ferrox-rc/wingfc-hardware/kicad/WingFC.kicad_pcb

## KiCad design kicad/WingFC.kicad_pcb (2026-10-21)

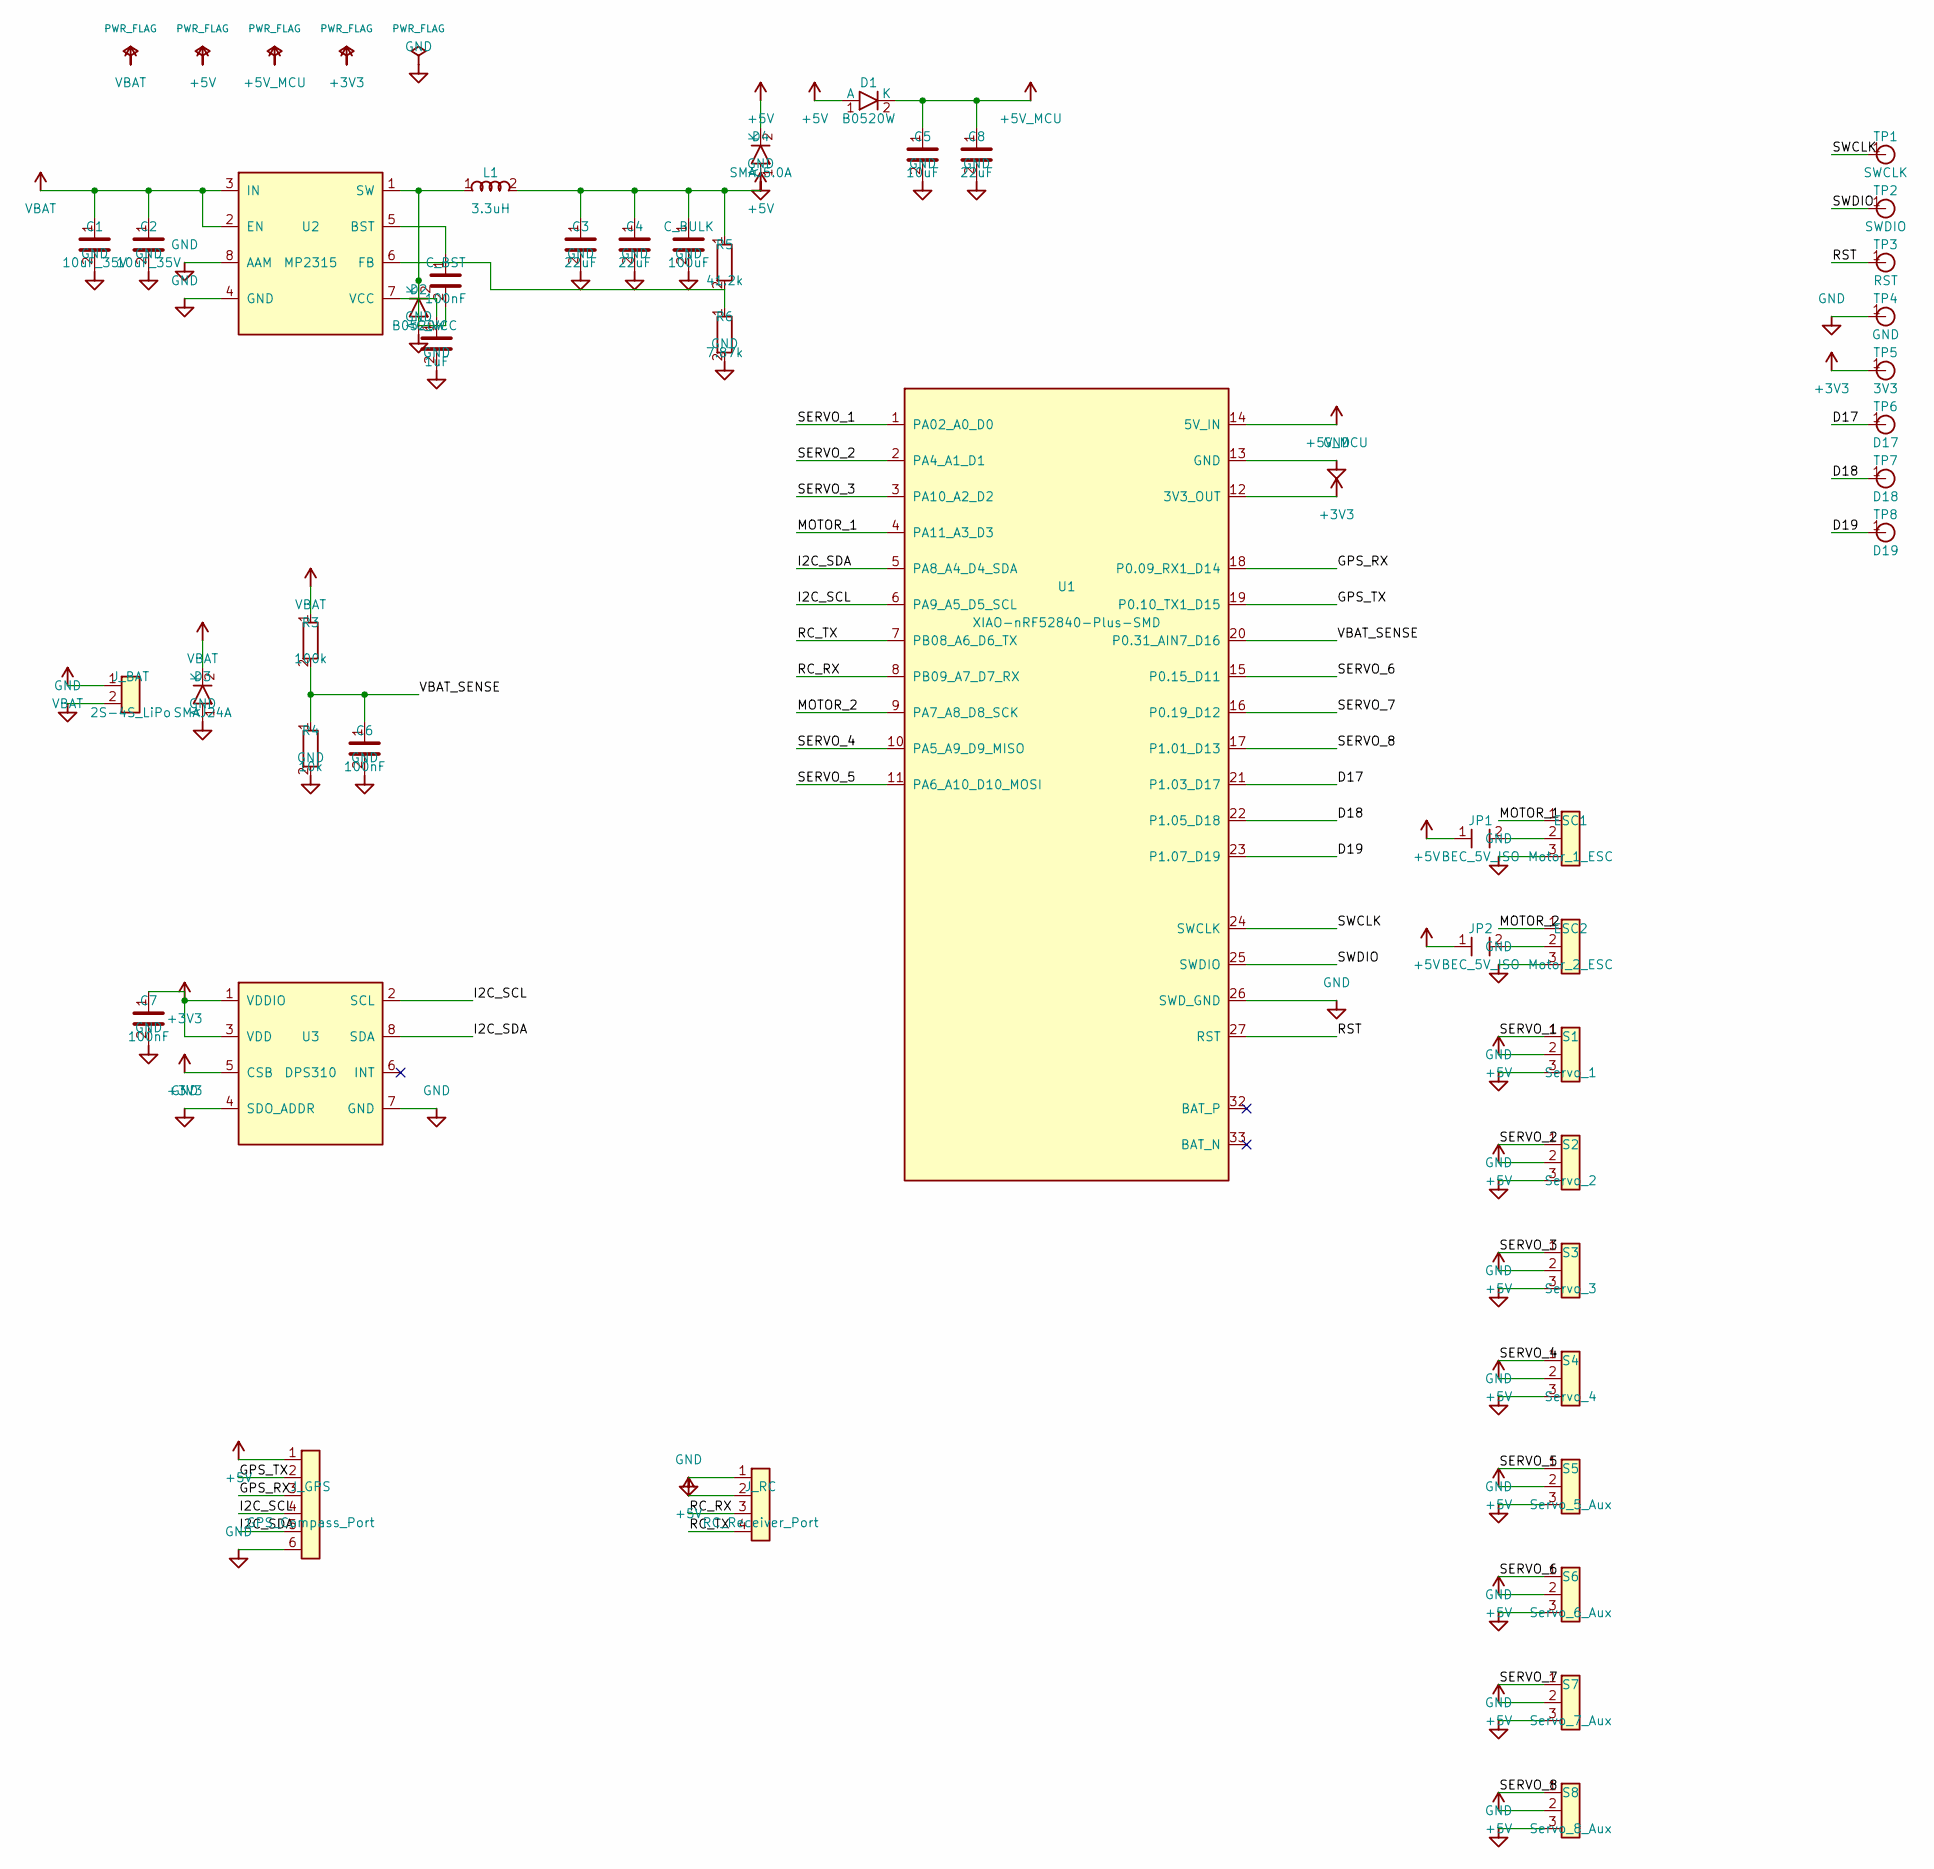
[picture p4: schematic WingFC.kicad_sch]

Parts:
C1, C2: 10uF_35V; C_0805_2012Metric
C3, C4, C8: 22uF; C_0805_2012Metric
C5: 10uF; C_0805_2012Metric
C6, C7: 100nF; C_0603_1608Metric
C_BST: 100nF; C_0603_1608Metric
C_BULK: 100uF; C_1206_3216Metric
C_VCC: 1uF; C_0603_1608Metric
D1, D2: B0520W; D_SOD-123
D3: SMAJ24A; D_SMA
D4: SMAJ5.0A; D_SMA
ESC1: Motor_1_ESC; PinHeader_1x03_P2.54mm_Vertical
ESC2: Motor_2_ESC; PinHeader_1x03_P2.54mm_Vertical
JP1, JP2: BEC_5V_ISO; SolderJumper-2_P1.3mm_Open_RoundedPad1.0x1.5mm
J_BAT: 2S-4S_LiPo; SolderWire-0.75sqmm_1x02_P4.8mm_D1.2mm_OD2.3mm
J_GPS: GPS_Compass_Port; JST_SH_SM06B-SRSS-TB_1x06-1MP_P1.00mm_Horizontal
J_RC: RC_Receiver_Port; JST_SH_SM04B-SRSS-TB_1x04-1MP_P1.00mm_Horizontal
L1: 3.3uH; L_Bourns_SRN4018
R3: 100k; R_0603_1608Metric
R4: 10k; R_0603_1608Metric
R5: 41.2k; R_0603_1608Metric
R6: 7.87k; R_0603_1608Metric
S1: Servo_1; PinHeader_1x03_P2.54mm_Vertical
S2: Servo_2; PinHeader_1x03_P2.54mm_Vertical
S3: Servo_3; PinHeader_1x03_P2.54mm_Vertical
S4: Servo_4; PinHeader_1x03_P2.54mm_Vertical
S5: Servo_5_Aux; PinHeader_1x03_P1.27mm_Vertical
S6: Servo_6_Aux; PinHeader_1x03_P1.27mm_Vertical
S7: Servo_7_Aux; PinHeader_1x03_P1.27mm_Vertical
S8: Servo_8_Aux; PinHeader_1x03_P1.27mm_Vertical
TP1: SWCLK; TestPoint_Pad_D1.5mm
TP2: SWDIO; TestPoint_Pad_D1.5mm
TP3: RST; TestPoint_Pad_D1.5mm
TP4: GND; TestPoint_Pad_D1.5mm
TP5: 3V3; TestPoint_Pad_D1.5mm
TP6: D17; TestPoint_Pad_D1.5mm
TP7: D18; TestPoint_Pad_D1.5mm
TP8: D19; TestPoint_Pad_D1.5mm
U1: XIAO-nRF52840-Plus-SMD
U2: MP2315; TSOT-23-8
U3: DPS310; Infineon_PG-VLGA-8-1_2.0x2.5mm_P0.65mm

Connections:
+3V3: C7.1, TP5.1, U1.12 (3V3_OUT), U3.1 (VDDIO), U3.3 (VDD), U3.5 (CSB)
+5V: C3.1, C4.1, C_BULK.1, D1.1 (A), D4.2 (K), JP1.1, JP2.1, J_GPS.1, J_RC.2, L1.2, R5.1, S1.2, S2.2, S3.2, S4.2, S5.2, S6.2, S7.2, S8.2
+5V_MCU: C5.1, C8.1, D1.2 (K), U1.14 (5V_IN)
/D17: TP6.1, U1.21 (P1.03_D17)
/D18: TP7.1, U1.22 (P1.05_D18)
/D19: TP8.1, U1.23 (P1.07_D19)
/GPS_RX: J_GPS.3, U1.18 (P0.09_RX1_D14)
/GPS_TX: J_GPS.2, U1.19 (P0.10_TX1_D15)
/I2C_SCL: J_GPS.4, U1.6 (PA9_A5_D5_SCL), U3.2 (SCL)
/I2C_SDA: J_GPS.5, U1.5 (PA8_A4_D4_SDA), U3.8 (SDA)
/MOTOR_1: ESC1.1, U1.4 (PA11_A3_D3)
/MOTOR_2: ESC2.1, U1.9 (PA7_A8_D8_SCK)
/RC_RX: J_RC.3, U1.8 (PB09_A7_D7_RX)
/RC_TX: J_RC.4, U1.7 (PB08_A6_D6_TX)
/RST: TP3.1, U1.27 (RST)
/SERVO_1: S1.1, U1.1 (PA02_A0_D0)
/SERVO_2: S2.1, U1.2 (PA4_A1_D1)
/SERVO_3: S3.1, U1.3 (PA10_A2_D2)
/SERVO_4: S4.1, U1.10 (PA5_A9_D9_MISO)
/SERVO_5: S5.1, U1.11 (PA6_A10_D10_MOSI)
/SERVO_6: S6.1, U1.15 (P0.15_D11)
/SERVO_7: S7.1, U1.16 (P0.19_D12)
/SERVO_8: S8.1, U1.17 (P1.01_D13)
/SWCLK: TP1.1, U1.24 (SWCLK)
/SWDIO: TP2.1, U1.25 (SWDIO)
/VBAT_SENSE: C6.1, R3.2, R4.1, U1.20 (P0.31_AIN7_D16)
GND: C1.2, C2.2, C3.2, C4.2, C5.2, C6.2, C7.2, C8.2, C_BULK.2, C_VCC.2, D2.1 (A), D3.1 (A), D4.1 (A), ESC1.3, ESC2.3, J_BAT.2, J_GPS.6, J_RC.1, R4.2, R6.2, S1.3, S2.3, S3.3, S4.3, S5.3, S6.3, S7.3, S8.3, TP4.1, U1.13 (GND), U1.26 (SWD_GND), U2.4 (GND), U2.8 (AAM), U3.4 (SDO_ADDR), U3.7 (GND)
unnamed: C_BST.2, D2.2 (K), L1.1, U2.1 (SW)
unnamed: ESC1.2, JP1.2
unnamed: ESC2.2, JP2.2
unnamed: C_BST.1, U2.5 (BST)
unnamed: R5.2, R6.1, U2.6 (FB)
unnamed: C_VCC.1, U2.7 (VCC)
VBAT: C1.1, C2.1, D3.2 (K), J_BAT.1, R3.1, U2.2 (EN), U2.3 (IN)

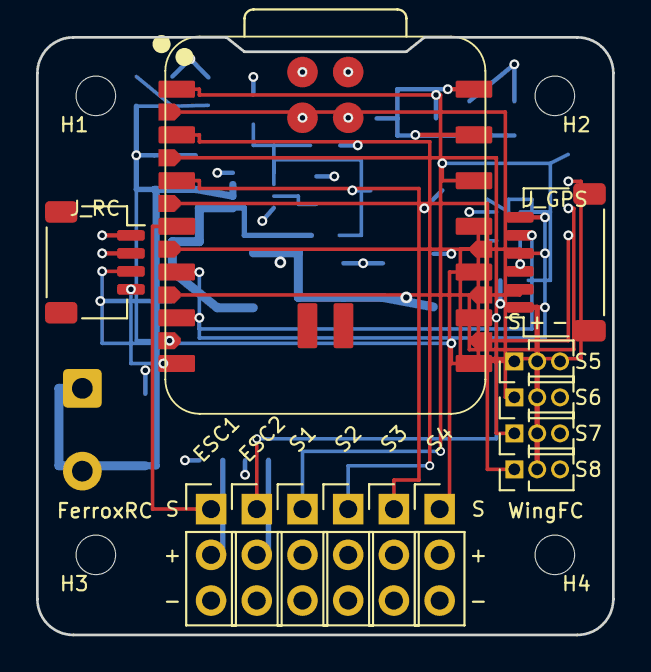
[picture p5: board WingFC.kicad_pcb from above]

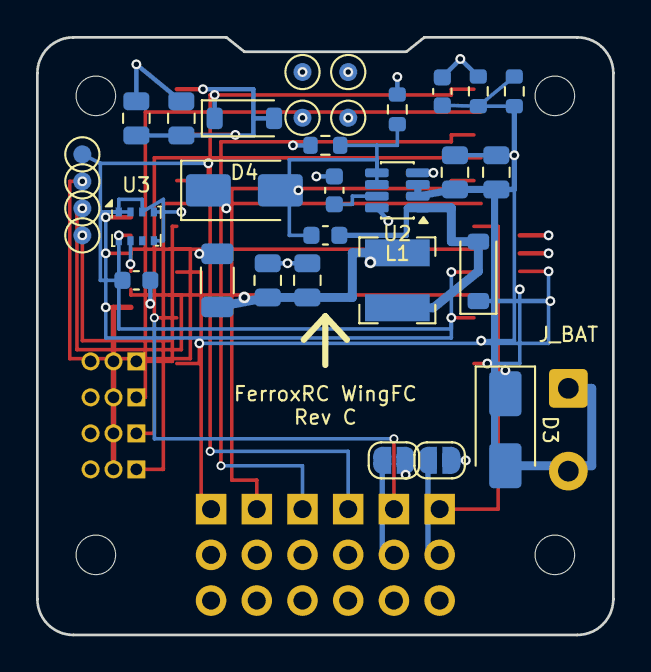
[picture p6: board WingFC.kicad_pcb from below]

Board: 4 copper layers, 32.0 x 33.2 mm, 50 parts (33 on the bottom side), 34 nets.

Other parts of the board:
H1, H2, H3, H4: MountingHole_2.2mm_M2
