ferrox-rc/wingfc-hardware/(commit log)

2026-09-26 feat(hardware): Initial standalone release of WingFC carrier board (Rev B)
2026-10-20 feat(hardware): compact 32x33.2mm redesign, 10ch actuator layout, and power protection
    - Shrink carrier board footprint to 32.0 x 33.2 mm (25.5 x 25.5 mm M2 pattern)
    - Implement 10-channel actuation: 6 primary 2.54mm pin headers (2 ESCs + 4 Servos) between rear mounting screws and 4 auxiliary 1.27mm pin headers in East pocket
    - Fix 3-hole pin header alignment and pad edge margins
    - Add transient protection (VBAT TVS SMAJ24A, +5V TVS SMAJ5.0A)
    - Add 100uF 1206 bulk servo cap, B0520W diode isolation, and 22uF hold-up cap on +5V_MCU
    - Add ESC BEC isolation solder jumpers (JP1, JP2) on B.Cu
    - Orient horizontal JST-SH RC and GPS connectors outward
    - Add antenna keepout zone across all copper laye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
2026-10-20 fix(silkscreen): isolate flight arrow, add FerroxRC branding, and refine label clearances
2026-10-20 fix(silkscreen): move arrow to bottom, balance branding at H3/H4, angle actuator labels 45 deg, and add aux polarity labels
2026-10-21 WIP: first-pass routing, silkscreen cleanup, aux servo labels (DRC not yet clean)
