ferrox-rc/wingfc-hardware/(notices)

Notices in the files:
README.md:
License: MIT
